smurn/knobly/knobly v1.jpg

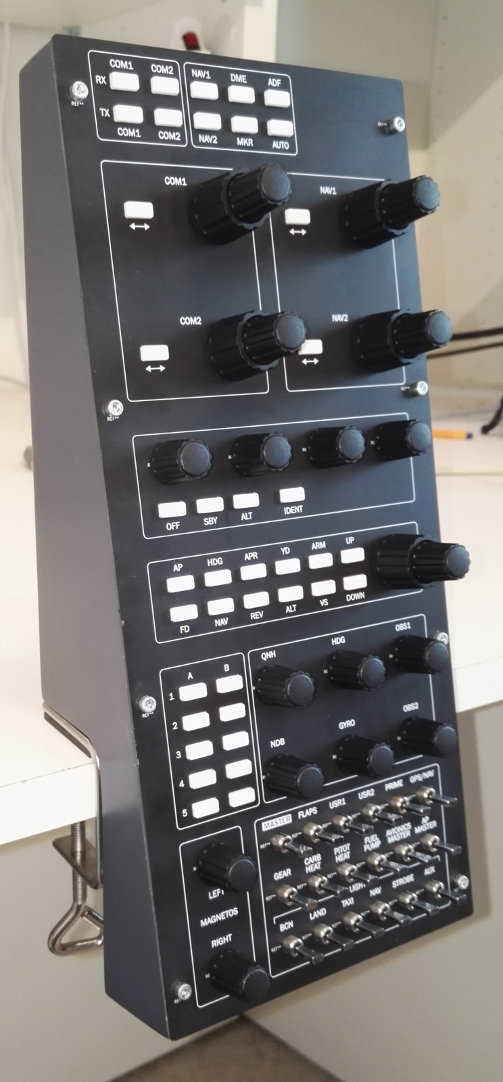
knobly v1.jpg
