smurn/knobly/populated pcb.jpg

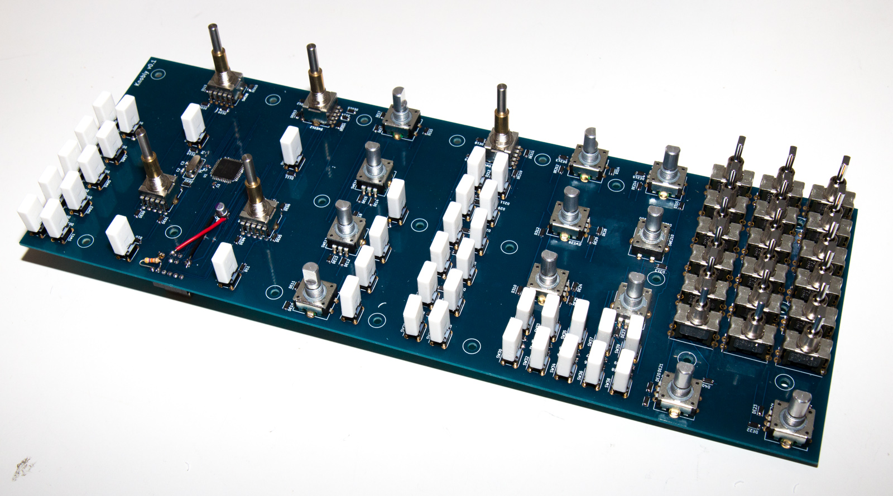
populated pcb.jpg
