smurn/knobly/README.txt

Knobly - Avionics input device for flight simulators
====================================================
