smurn/knobly/knoblyfirmware.X/README.txt

Warning:
If the programmer is connected, some buttons will show to be permanently pressed.
