smurn/knobly/3d-printed parts/topmount.stl

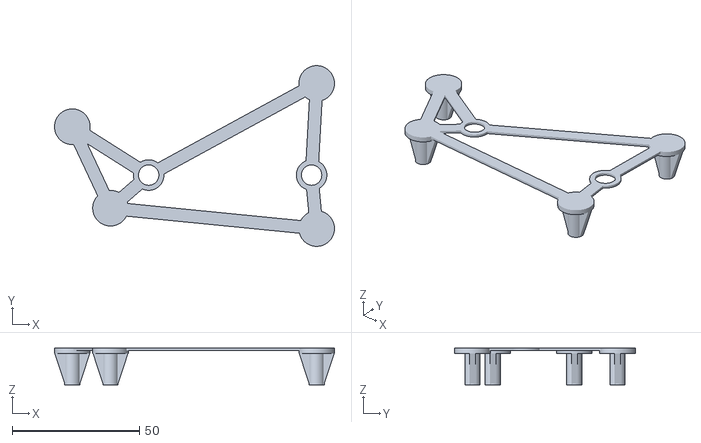
[picture p3: CAD file, 2017-12-11]
3d-printed parts/topmount.stl
110.0 x 71.0 x 14.4
