smurn/knobly/3d-printed parts/front_jig_5mm.stl

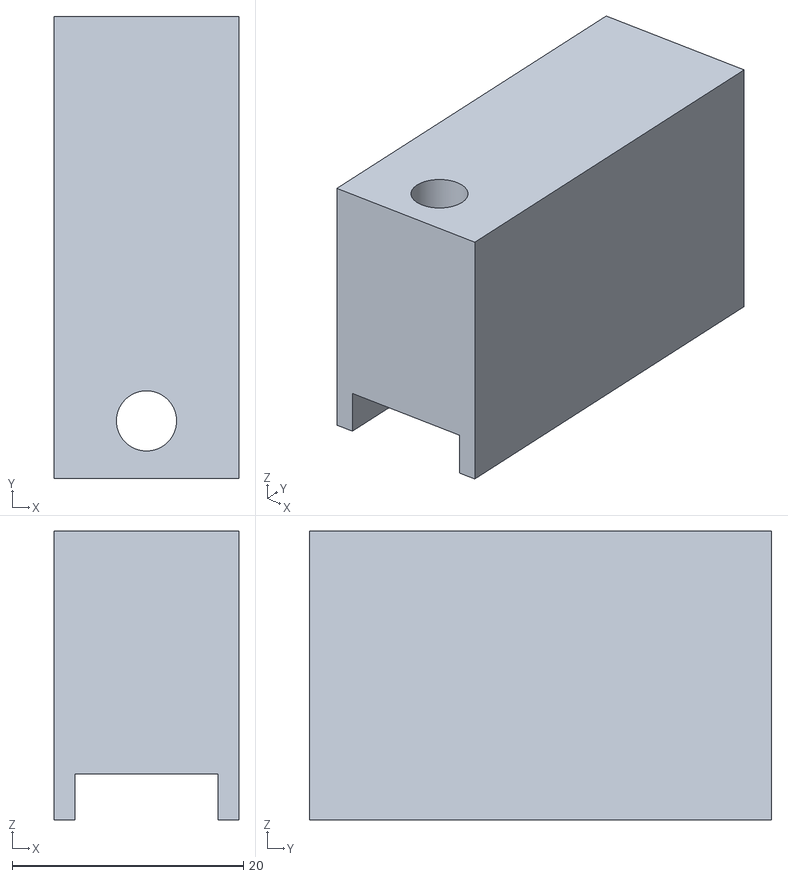
[picture p4: CAD file, 2017-12-11]
3d-printed parts/front_jig_5mm.stl
16.0 x 40.0 x 25.0
