smurn/knobly/3d-printed parts/distanceholder.stl

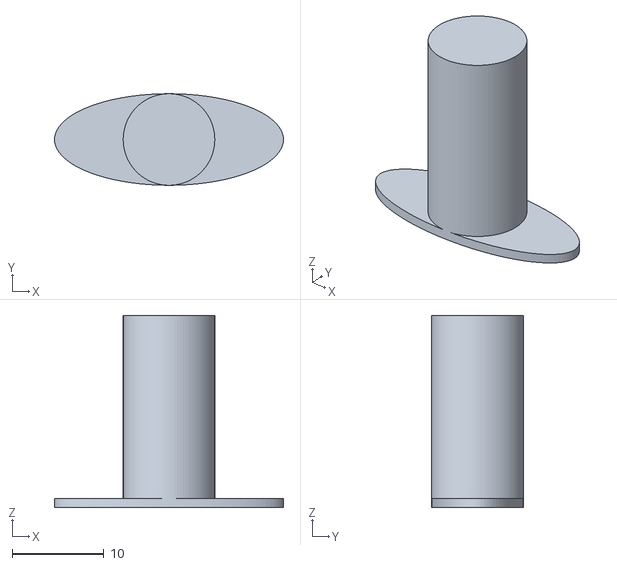
[picture p5: CAD file, 2017-12-11]
3d-printed parts/distanceholder.stl
25.0 x 9.99 x 21.0
