smurn/knobly/3d-printed parts/centermount.stl

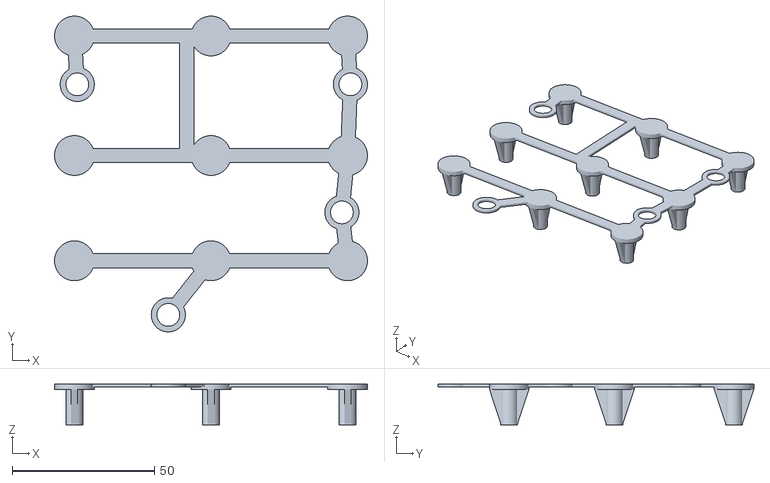
[picture p6: CAD file, 2017-12-11]
3d-printed parts/centermount.stl
110.0 x 111.0 x 14.4
