smurn/knobly/3d-printed parts/cap.stl

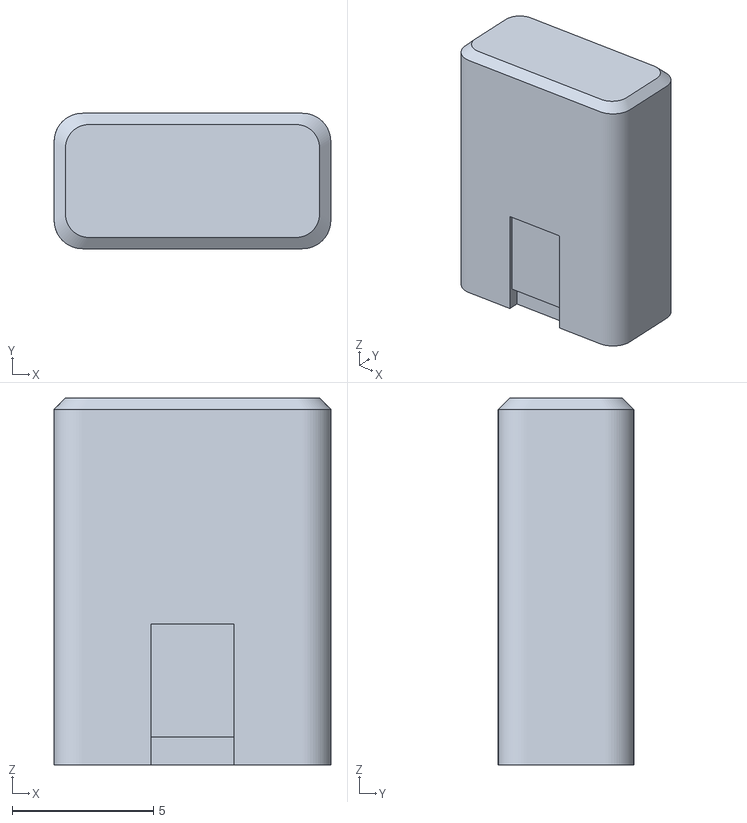
[picture p7: CAD file, 2017-12-11]
3d-printed parts/cap.stl
9.80 x 4.80 x 13.0
