smurn/knobly/3d-printed parts/clamp_side_jig.stl

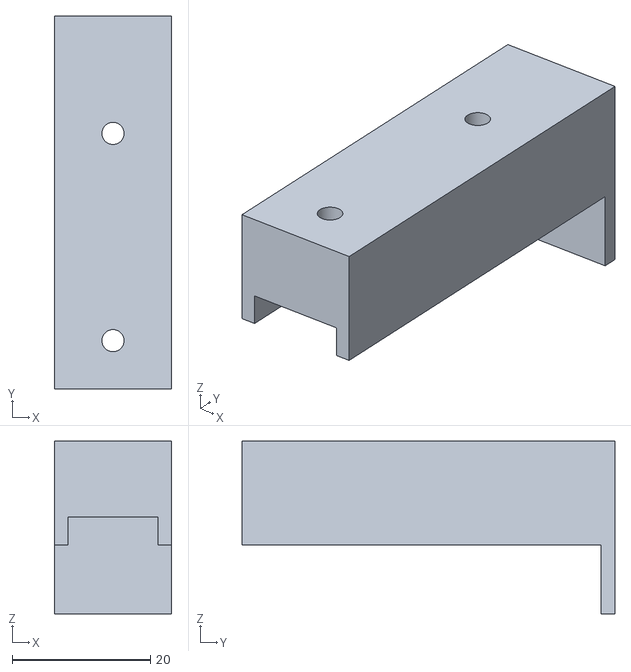
[picture p8: CAD file, 2017-12-11]
3d-printed parts/clamp_side_jig.stl
17.0 x 54.0 x 25.0
