smurn/knobly/3d-printed parts/clamp_top_jig.stl

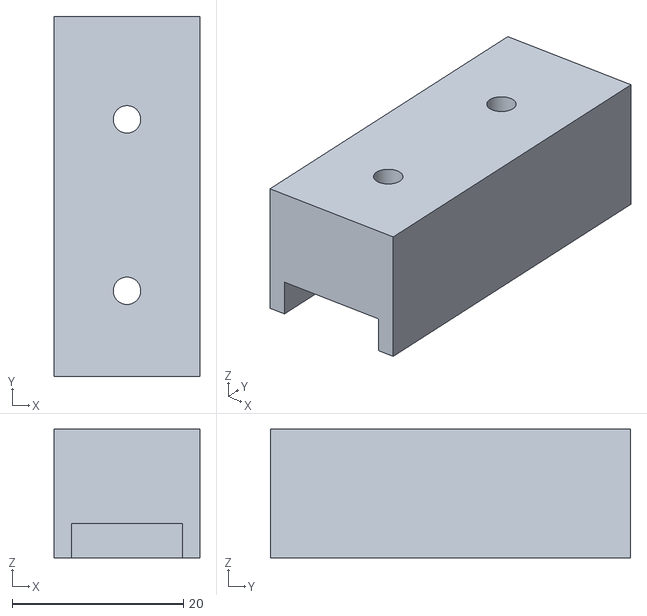
[picture p9: CAD file, 2017-12-11]
3d-printed parts/clamp_top_jig.stl
17.0 x 42.0 x 15.0
