smurn/knobly/3d-printed parts/clamp_plate.stl

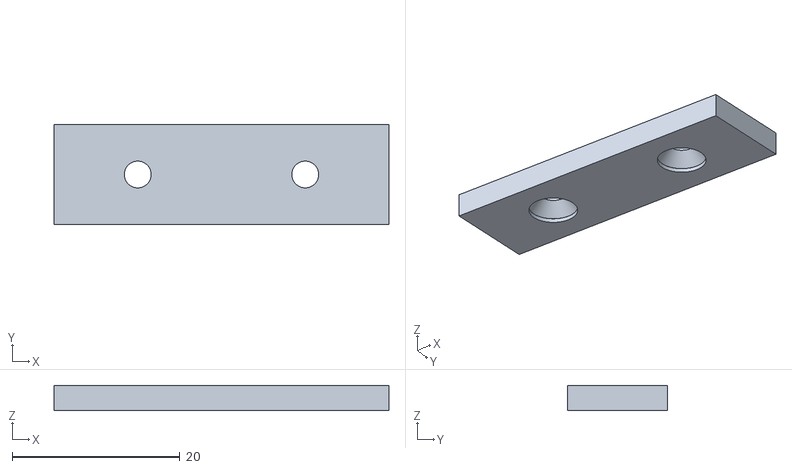
[picture p10: CAD file, 2017-12-11]
3d-printed parts/clamp_plate.stl
40.0 x 12.0 x 3.00
