smurn/knobly/3d-printed parts/frontmount.stl

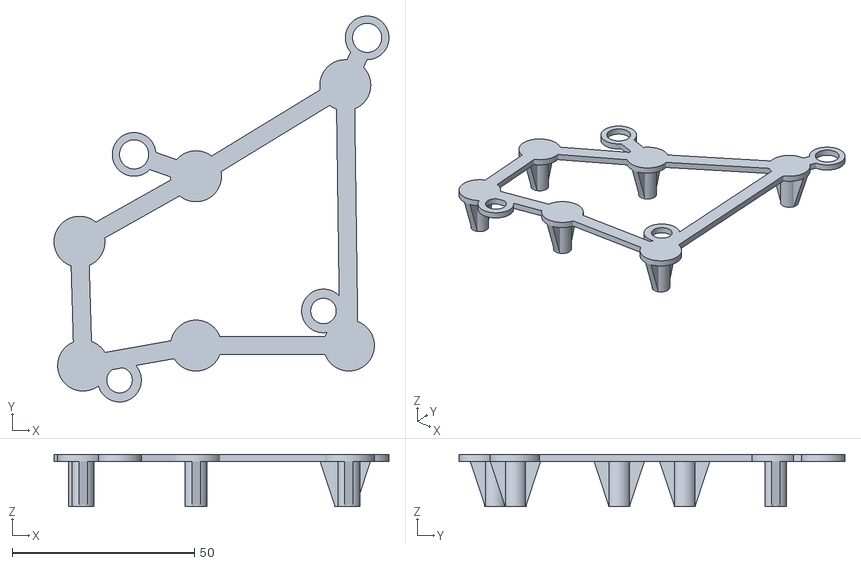
[picture p11: CAD file, 2017-12-11]
3d-printed parts/frontmount.stl
92.0 x 106.0 x 14.4
