smurn/knobly/3d-printed parts/e37_binary.stl

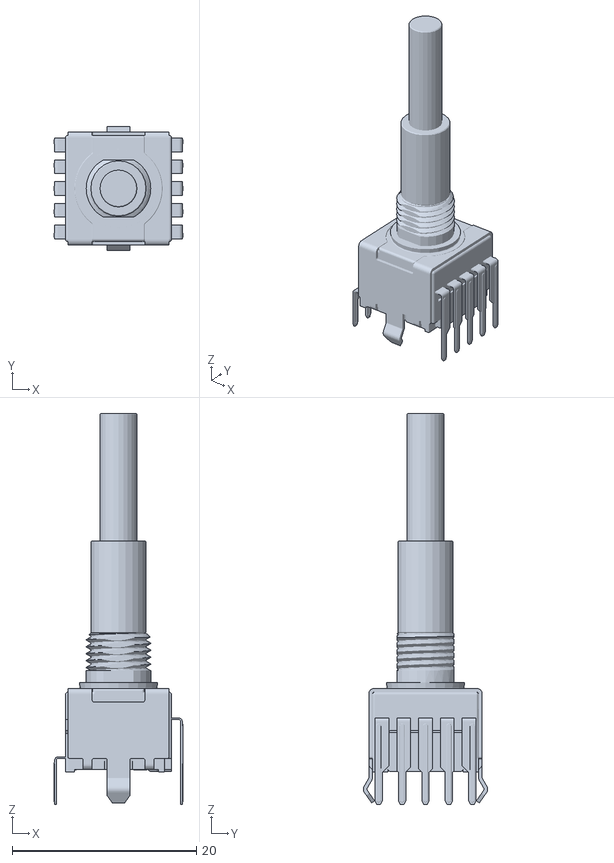
[picture p12: CAD file, 2017-12-11]
3d-printed parts/e37_binary.stl
14.0 x 13.5 x 42.4
