smurn/knobly/3d-printed parts/corner.stl

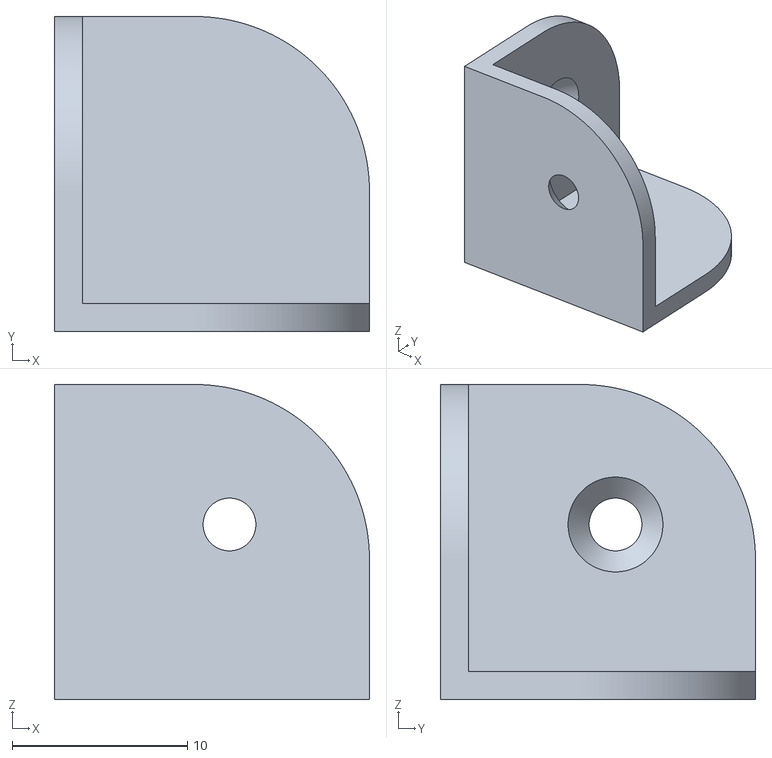
[picture p13: CAD file, 2017-12-11]
3d-printed parts/corner.stl
18.0 x 18.0 x 18.0
