smurn/knobly/3d-printed parts/front_jig.stl

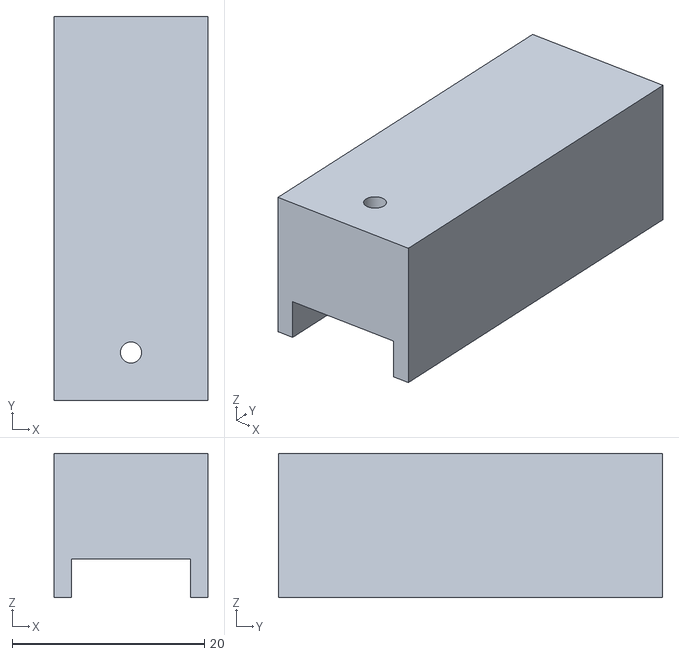
[picture p14: CAD file, 2017-12-11]
3d-printed parts/front_jig.stl
16.0 x 40.0 x 15.0
