smurn/knobly/3d-printed parts/M2018ES2G13_binary.stl

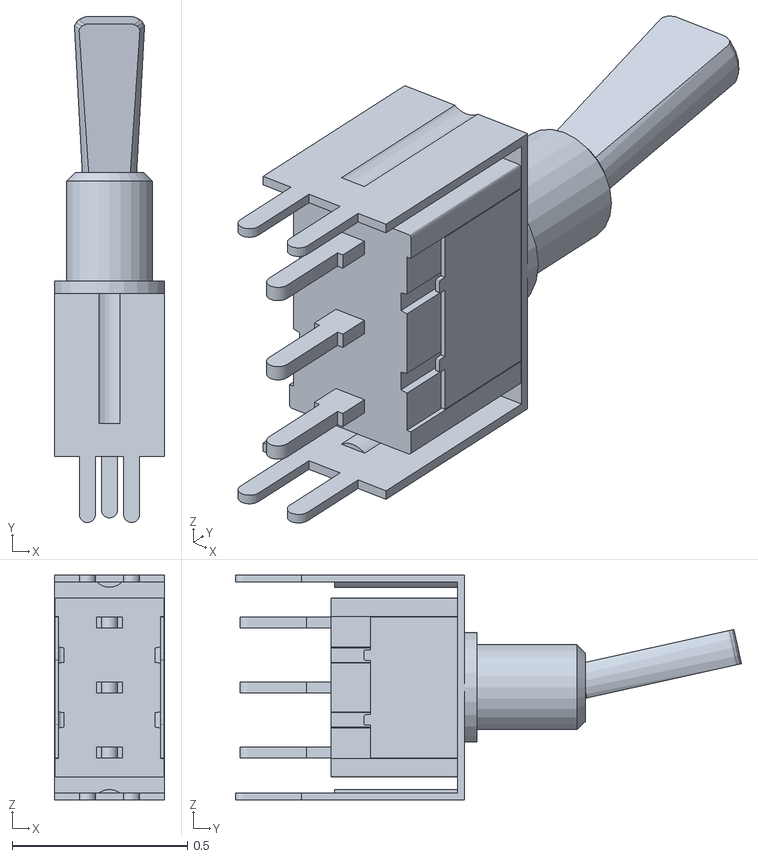
[picture p15: CAD file, 2017-12-11]
3d-printed parts/M2018ES2G13_binary.stl
0.315 x 1.44 x 0.642
