smurn/knobly/3d-printed parts/distanceholder.scad

$fa = 4;
$fs = 0.2;

cylinder(r=5,h=21);
scale([2.5,1,1])cylinder(r=5,h=1);
