smurn/knobly/(list of files, cad)

Other CAD files:
3d-printed parts/e37_binary2.stl
3d-printed parts/e37.stl
older stuff/knobly2.X/dist/default/production/knobly2.X.production.obj
older stuff/12039.stp
older stuff/CH13-E37-Dummy-E37-VTXXX0-1-C.stp
older stuff/M2018ES2G13.stp
older stuff/bottommount.stl
older stuff/case.FCStd
older stuff/e37.obj
older stuff/e37.stl
older stuff/e37_binary2.stl
older stuff/pec11r-4x25f-sxxxx.stp
