smurn/knobly/pcb/encmatrix-encoder matrix.pdf

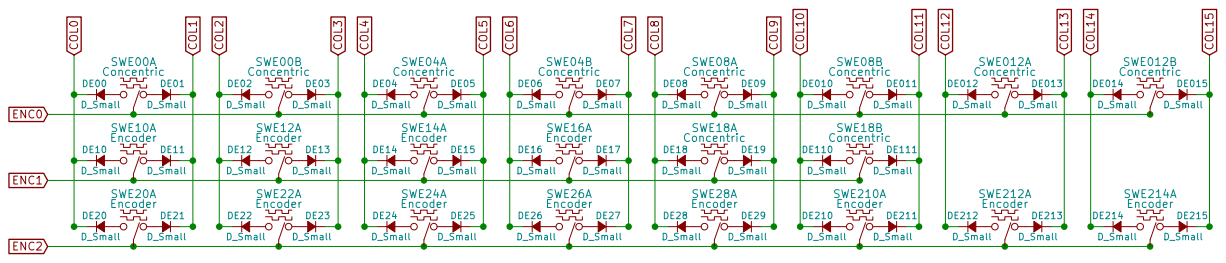
[picture p17: page 1]

File: encmatrix.sch Sheet: /encoder matrix/
Id: 4/4 Title: Rotary Encoder Matrix
