smurn/knobly/pcb/matrix-matrix.pdf

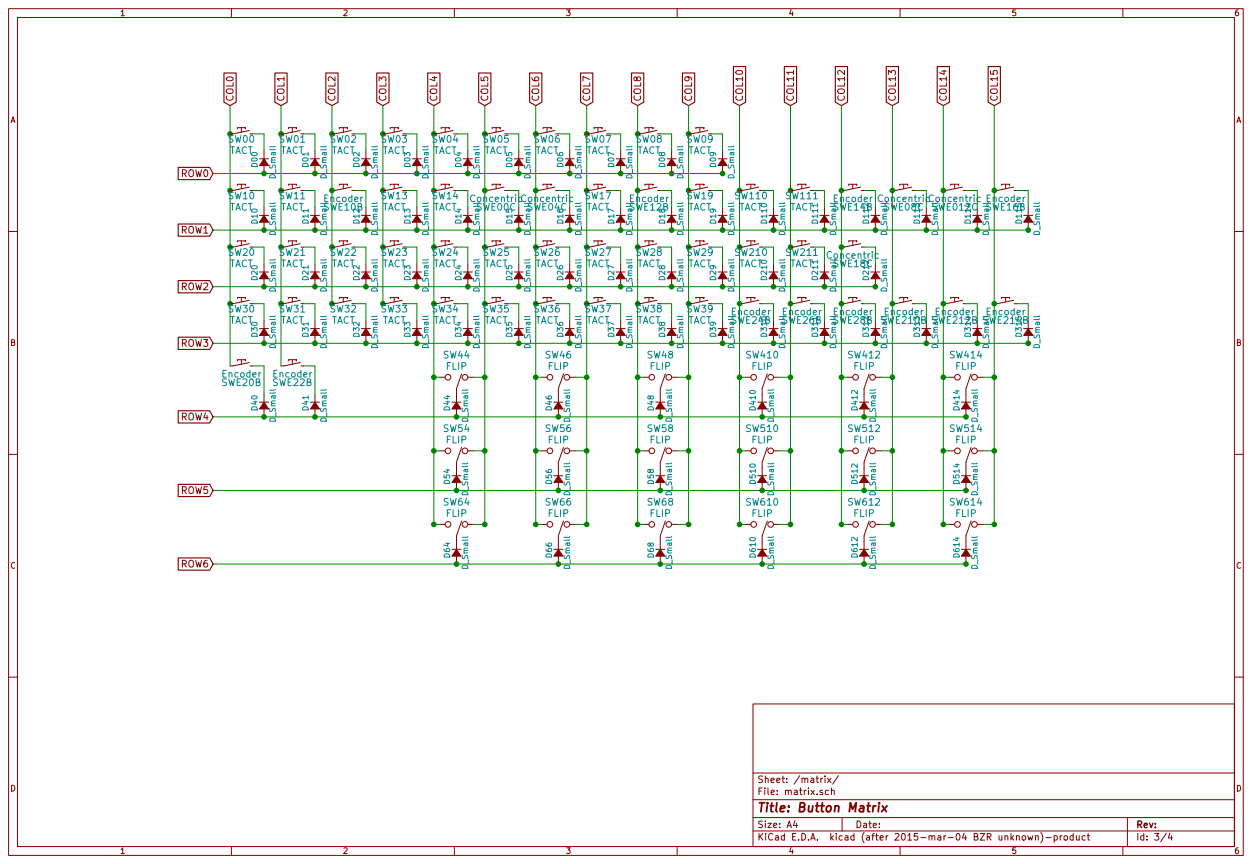
[picture p18: page 1]

Id: 3/4 Title: Button Matrix
