smurn/knobly/pcb/controller-controller.pdf

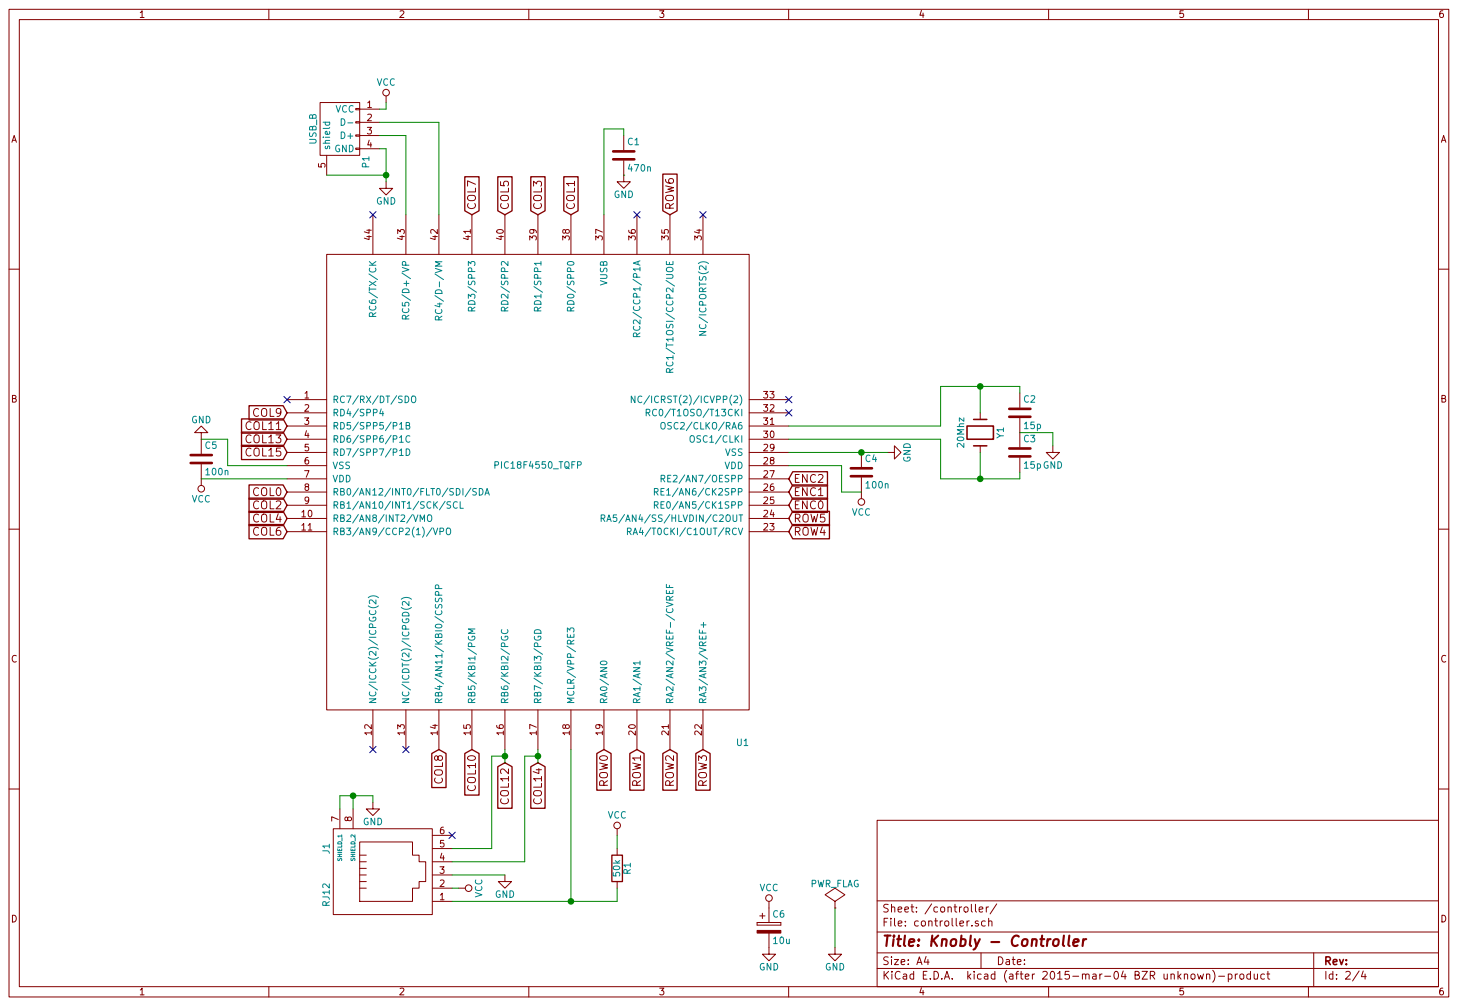
[picture p19: page 1]

Id: 2/4 Title: Knobly - Controller File: controller.sch Sheet: /controller/
