smurn/knobly/pcb/frontpanel.pdf

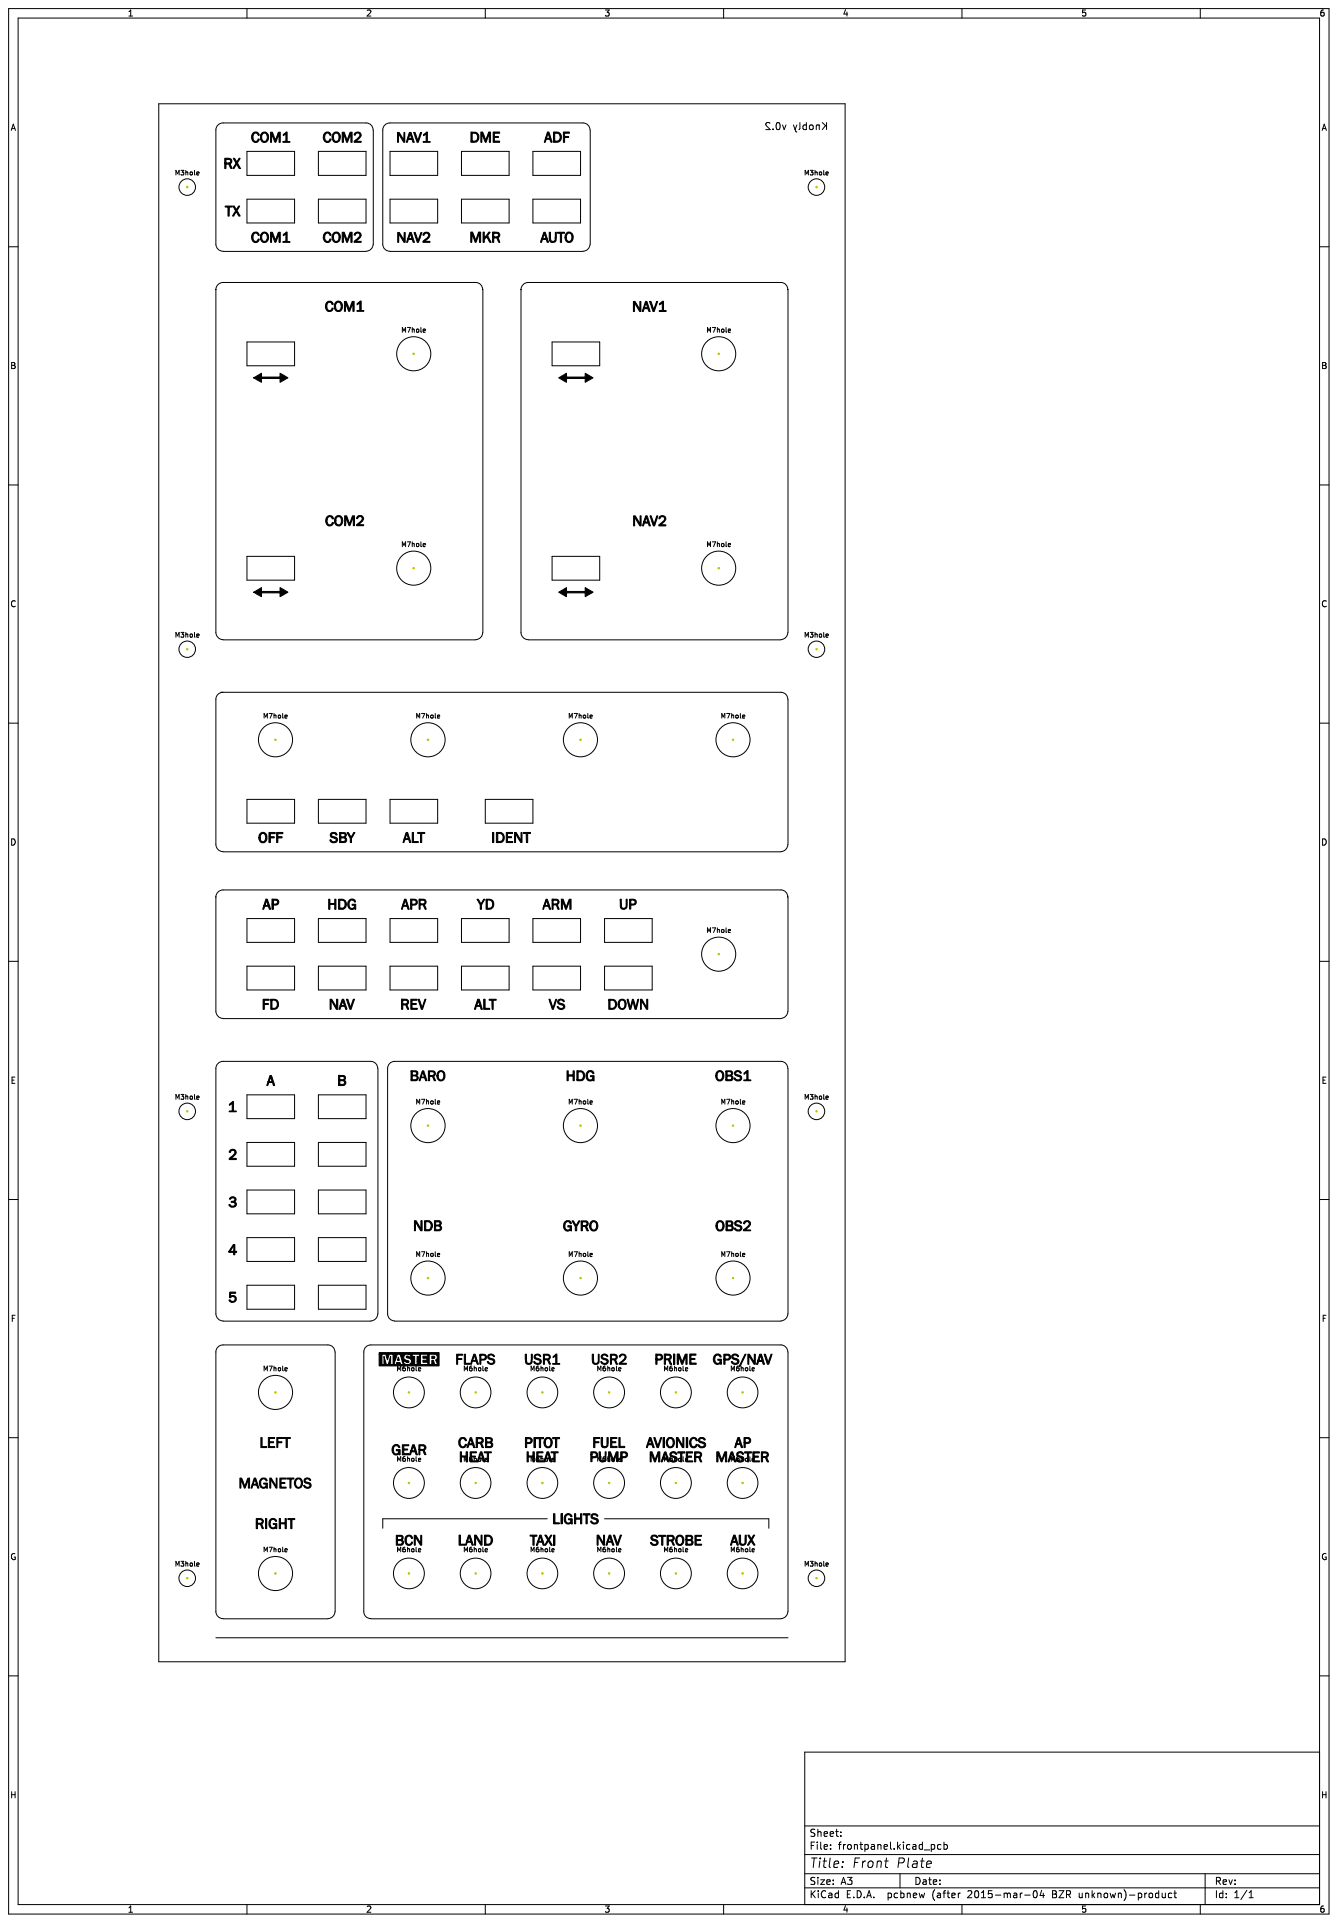
[picture p20: page 1]
