smurn/knobly/pcb/secondtry-B.Cu.pdf

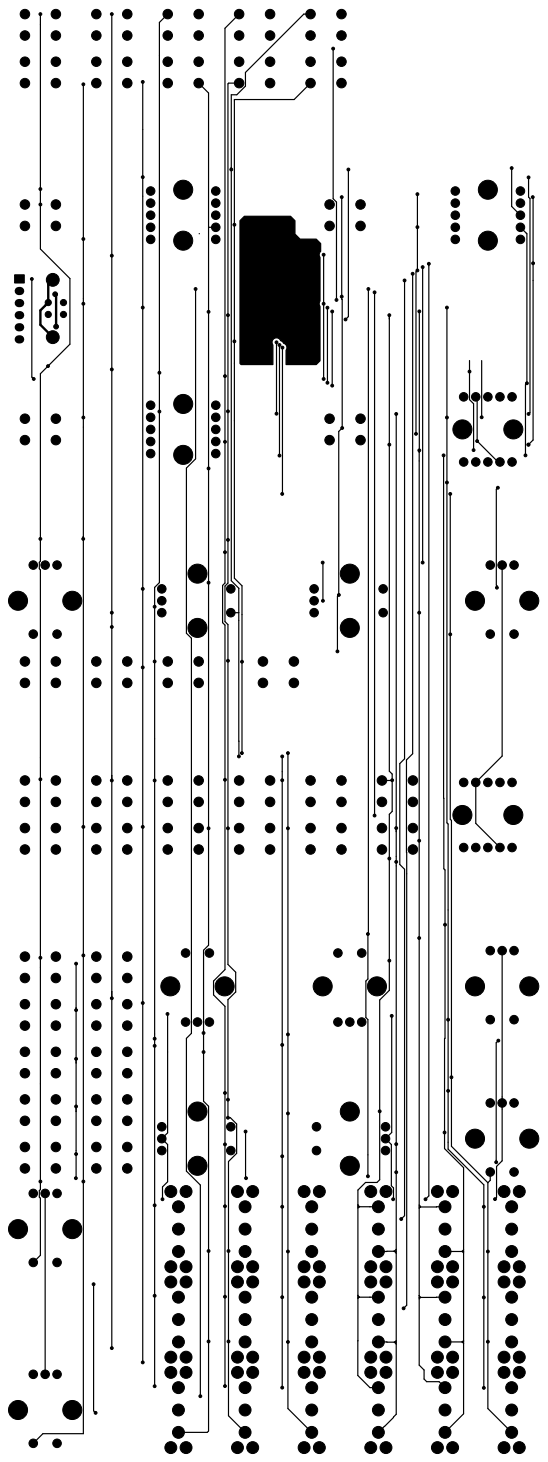
[picture p21: page 1]
