smurn/knobly/pcb/secondtry-B.SilkS.pdf

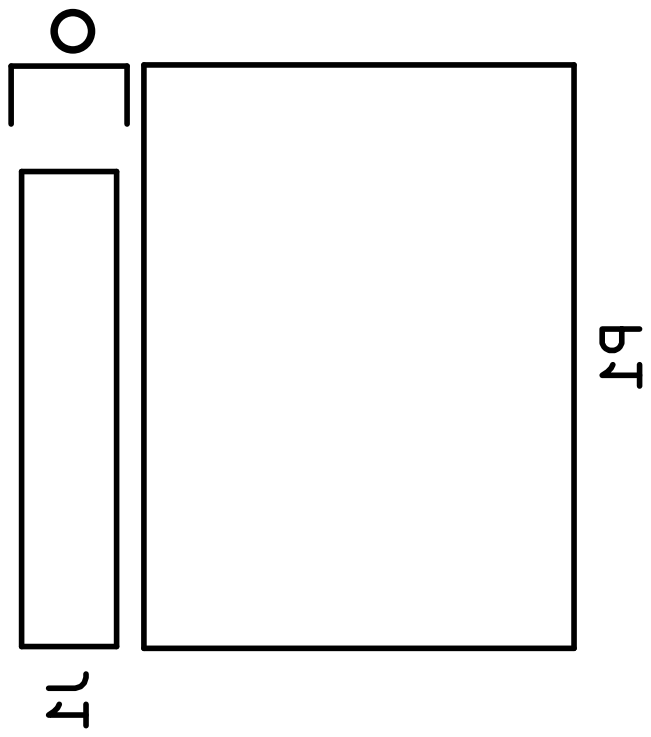
[picture p22: page 1]
