smurn/knobly/pcb/secondtry-F.Cu.pdf

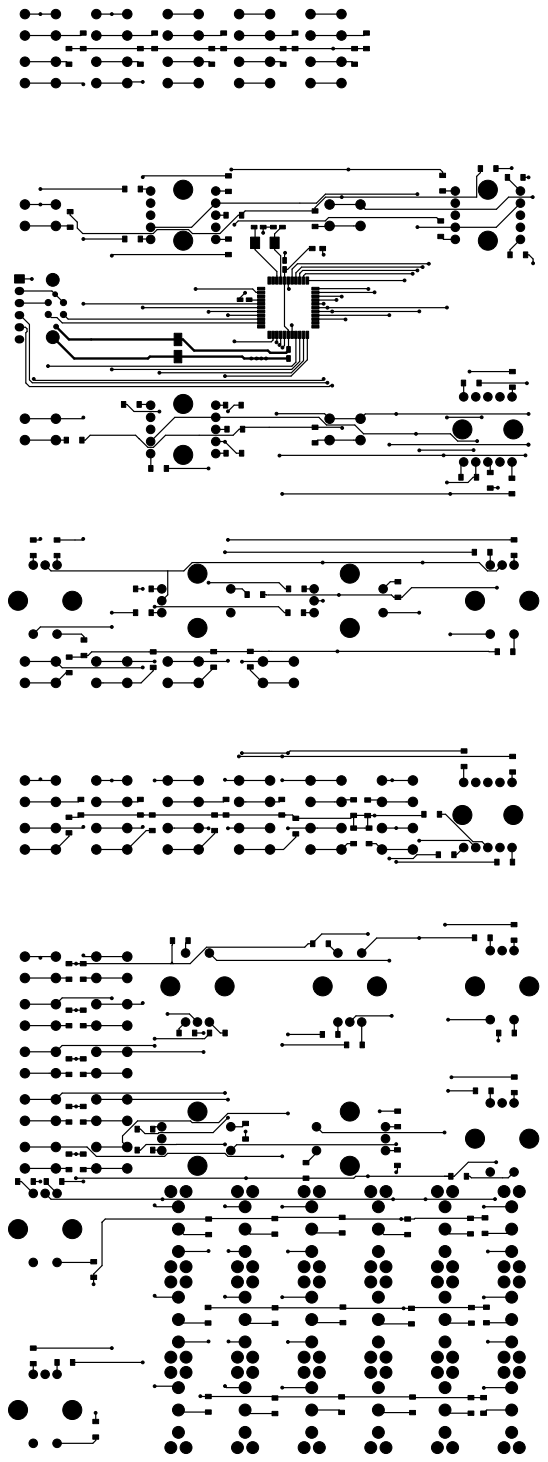
[picture p23: page 1]
