smurn/knobly/pcb/secondtry-F.SilkS.pdf

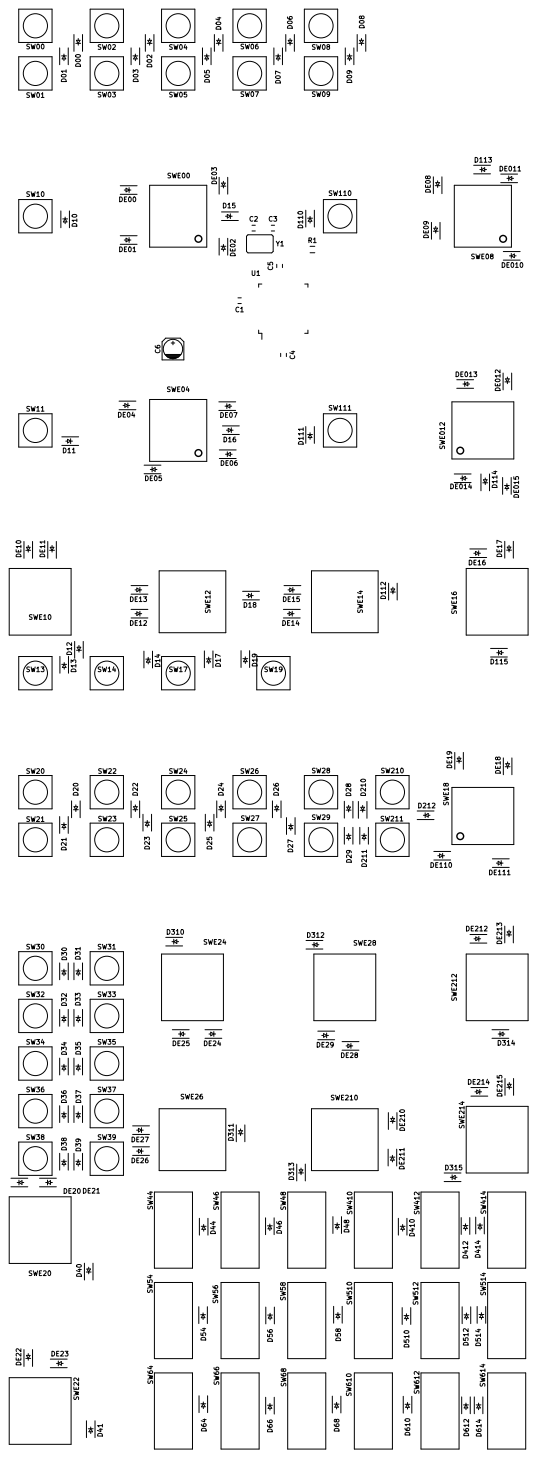
[picture p24: page 1]
