smurn/knobly/pcb/gerber_front/frontpanel-Edge_Cuts.pdf

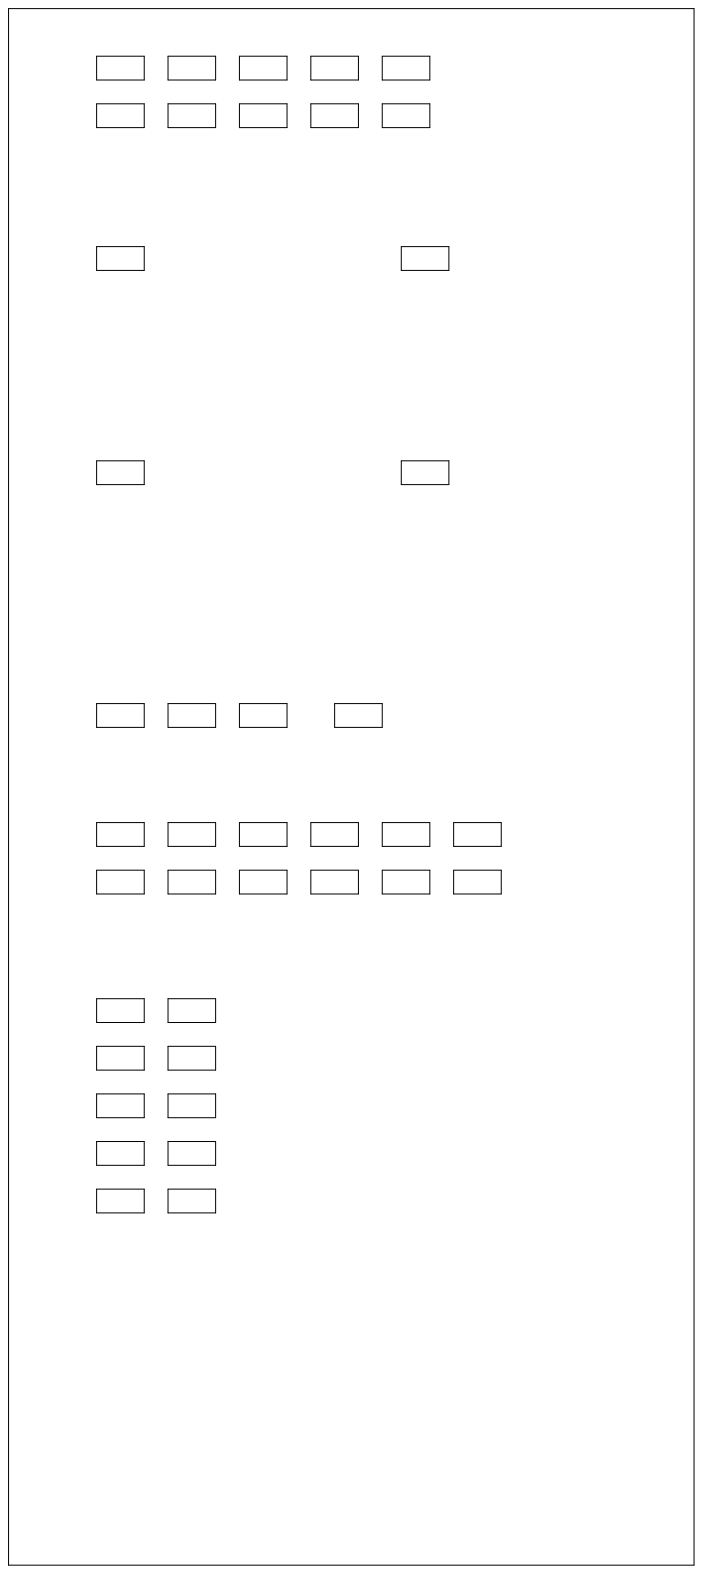
[picture p25: page 1]
