smurn/knobly/pcb/gerber_front/frontpanel-F_SilkS.pdf

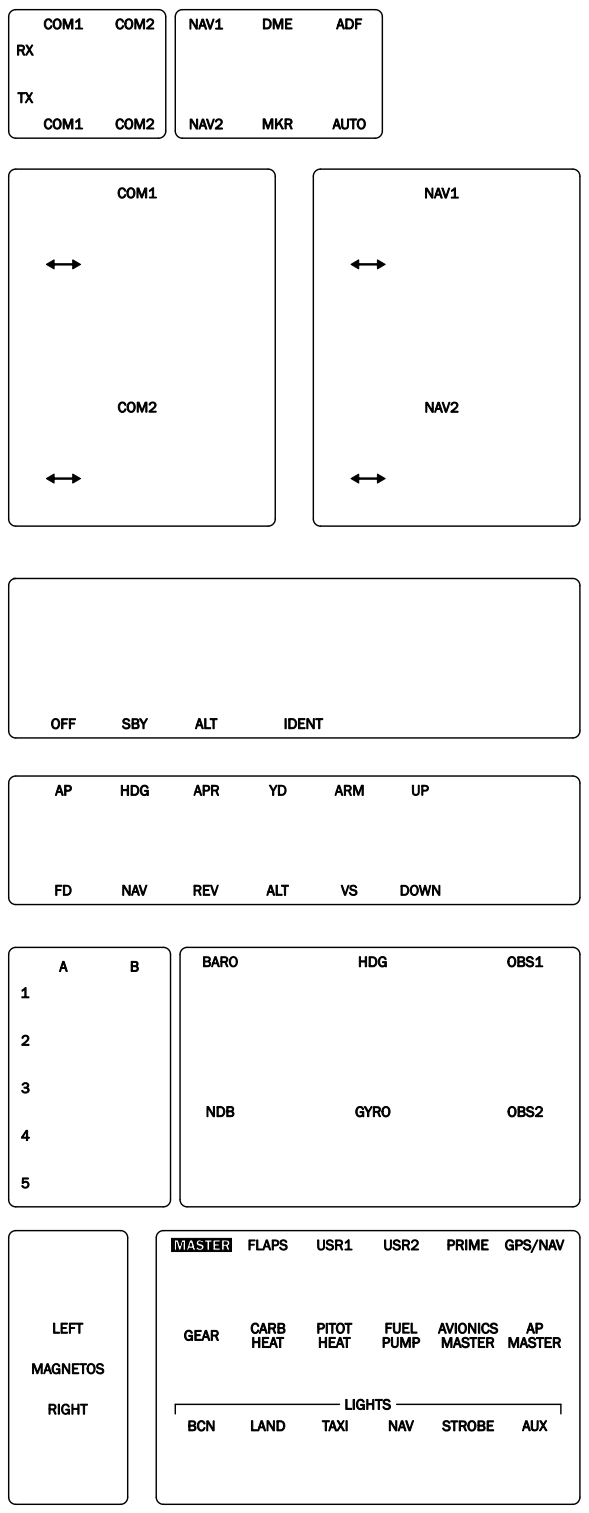
[picture p26: page 1]
