smurn/knobly/older stuff/components.pdf

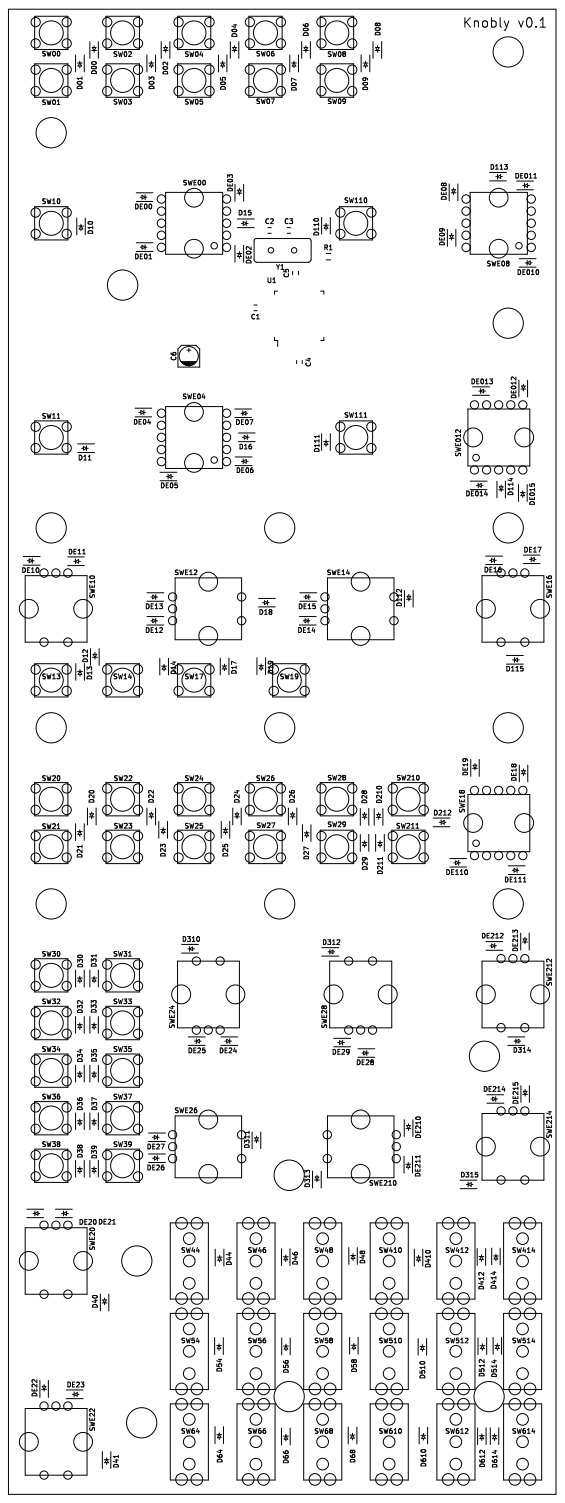
[picture p27: page 1]
