smurn/knobly/older stuff/Printing Print.pdf

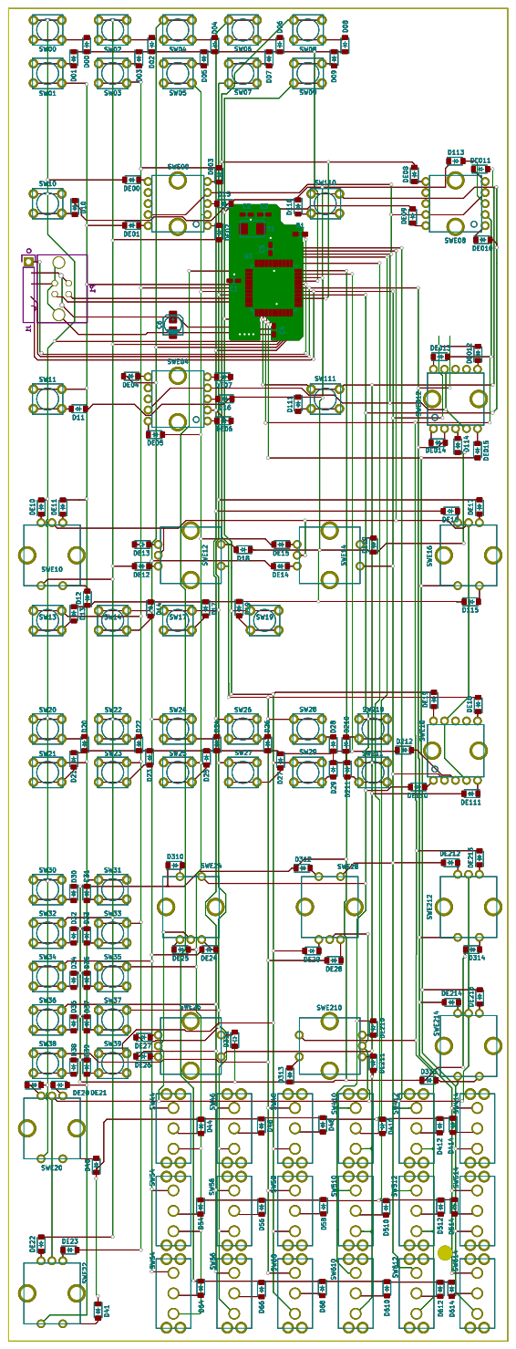
[picture p28: page 1]
