smurn/knobly/older stuff/componentsback.pdf

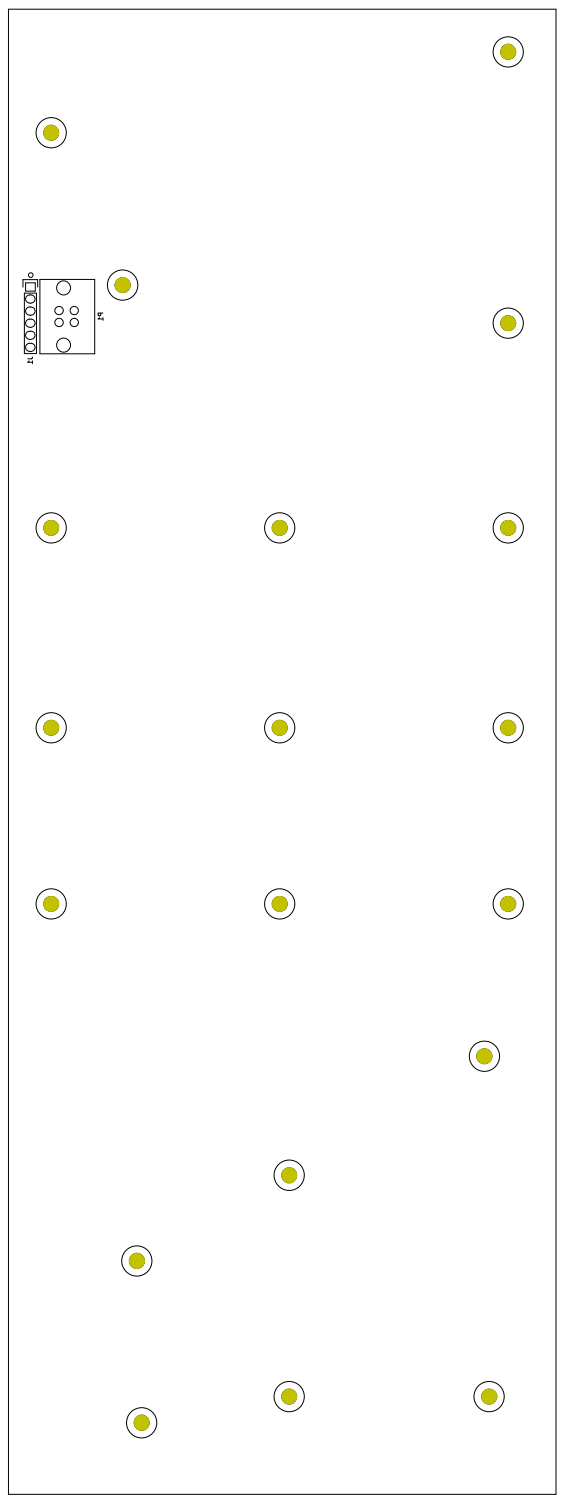
[picture p29: page 1]
