smurn/knobly/older stuff/frontpanel.pdf

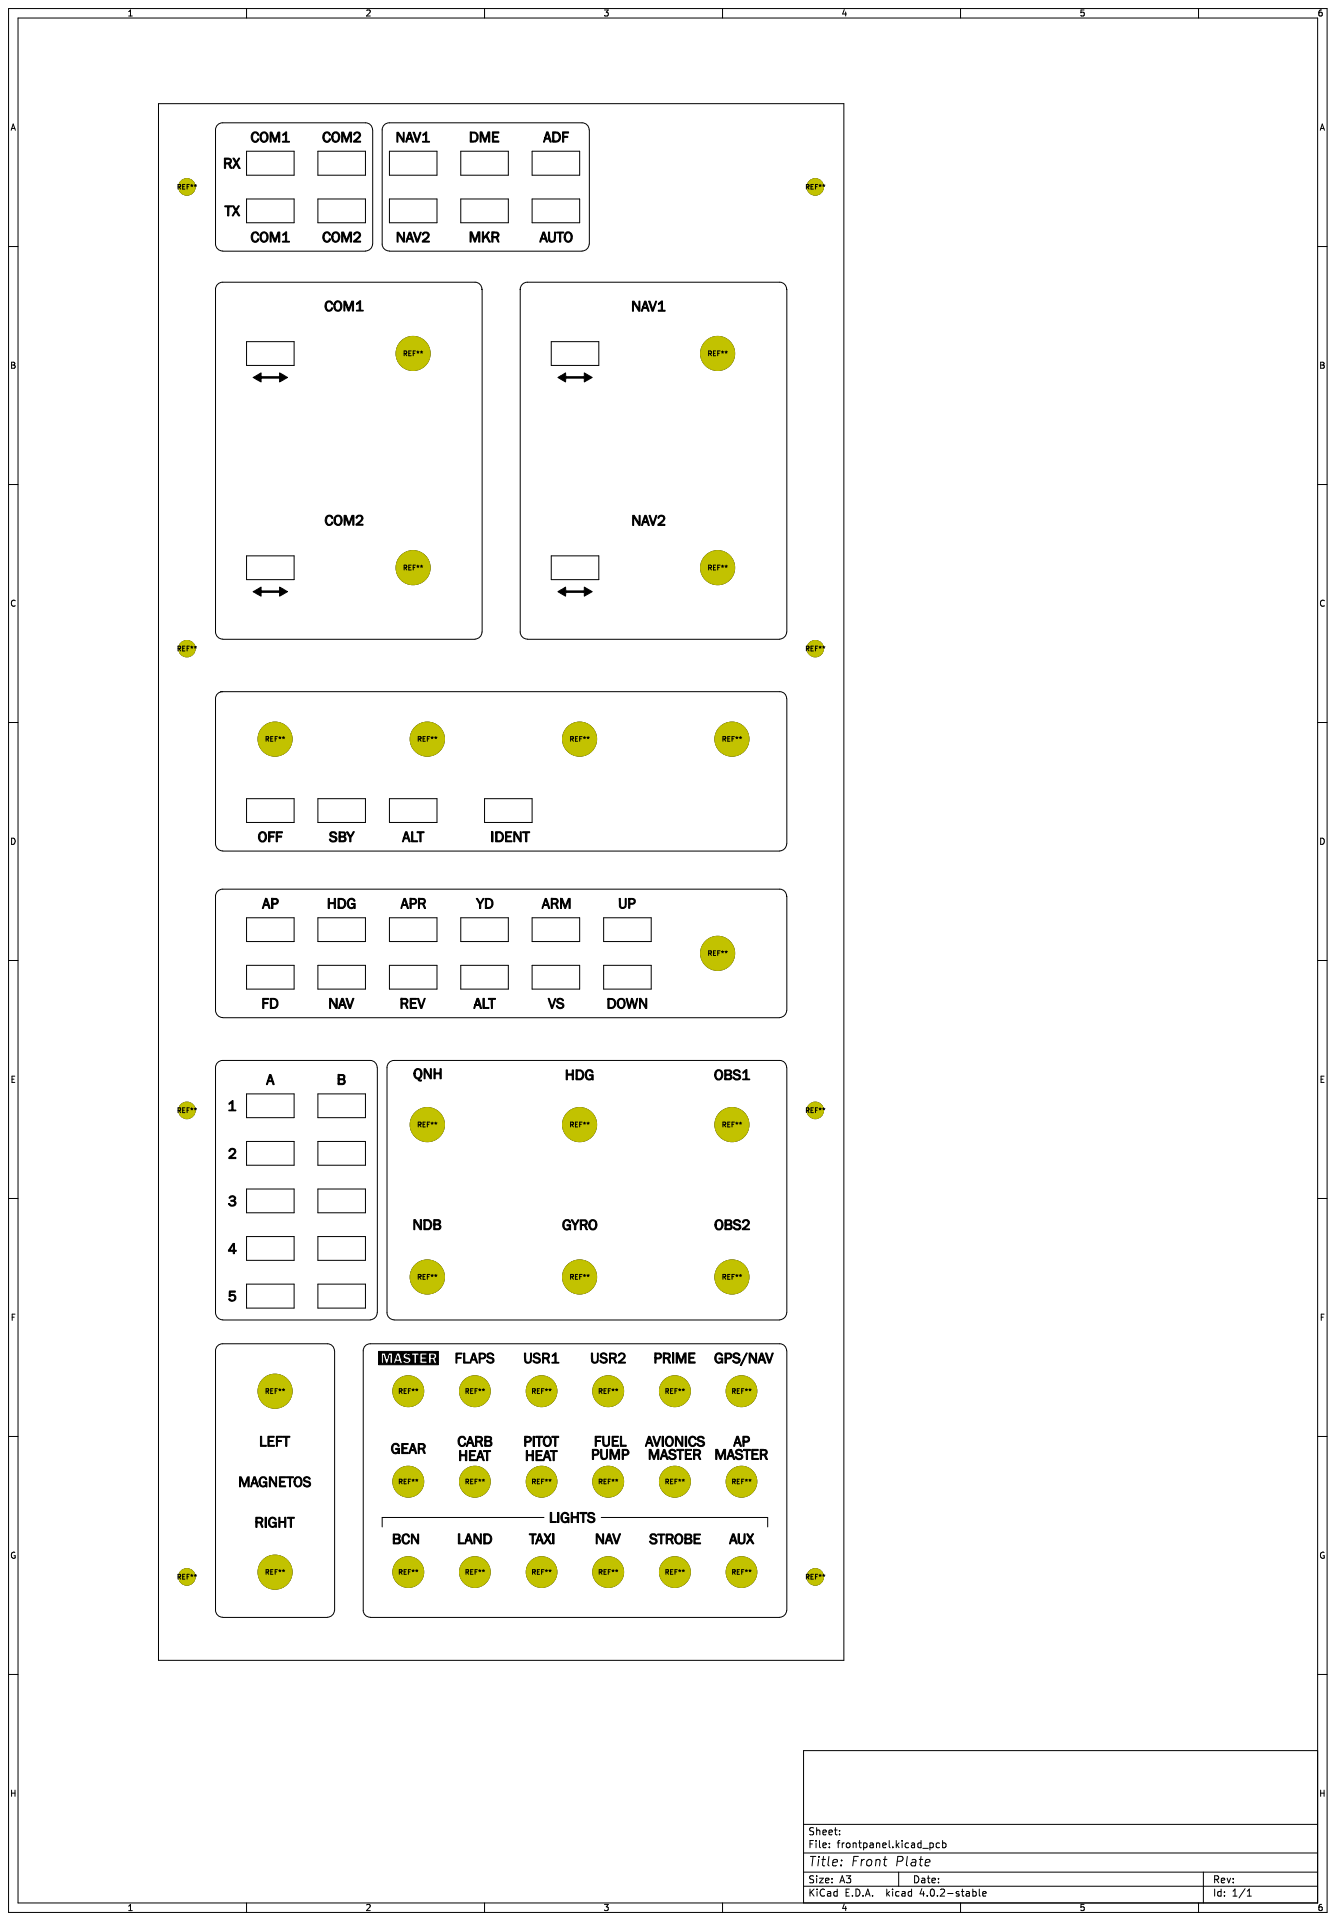
[picture p30: page 1]
