smurn/knobly/older stuff/pcb/knobly.kicad_pcb

## KiCad design older stuff/pcb/knobly.kicad_pcb (2017-12-11, an earlier design)

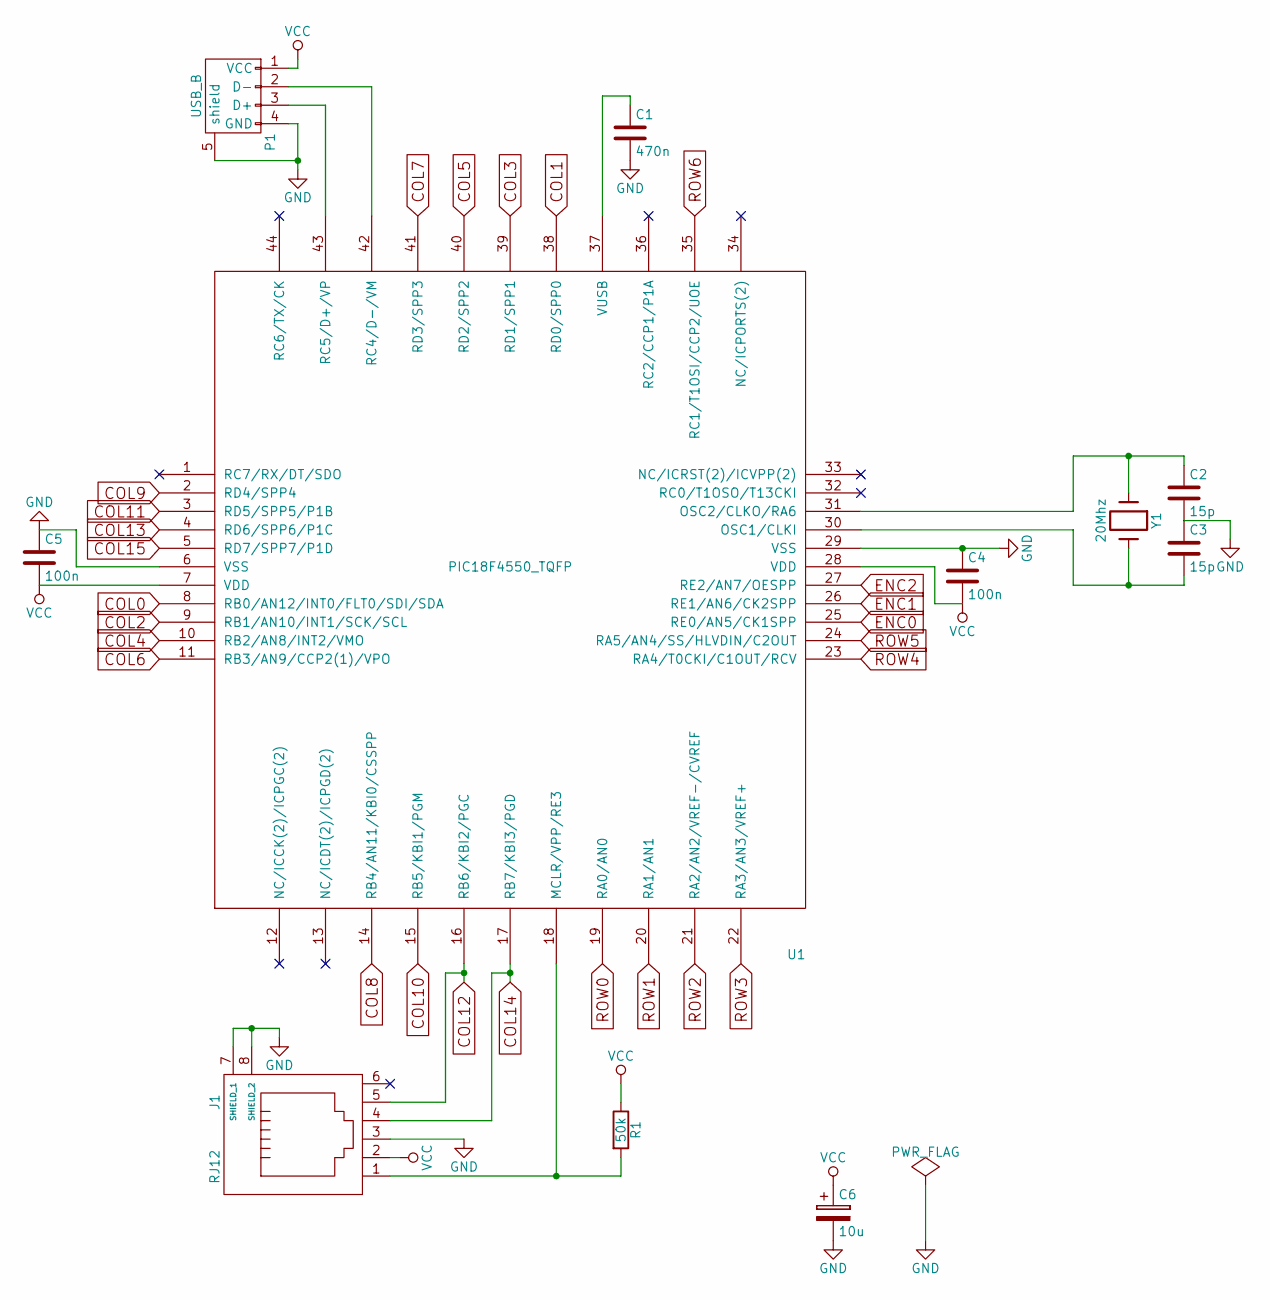
[picture p31: schematic controller.sch, Knobly - Controller]

Parts:
C1: 470n; C_0603_HandSoldering
C2, C3: 15p; C_0603_HandSoldering
C4, C5: 100n; C_0603_HandSoldering
C6: 10u; c_elec_4x4.5
J1: RJ12; Socket_Strip_Straight_1x06
P1: USB_B; USBBVertical
R1: 50k; R_0603_HandSoldering
U1: PIC18F4550_TQFP; TQFP-44_10x10mm_Pitch0.8mm
Y1: 20Mhz; HC49US

Connections:
COL0: U1.8 (RB0/AN12/INT0/FLT0/SDI/SDA); also elsewhere on the board
COL1: U1.38 (RD0/SPP0); also elsewhere on the board
COL2: U1.9 (RB1/AN10/INT1/SCK/SCL); also elsewhere on the board
COL3: U1.39 (RD1/SPP1); also elsewhere on the board
COL4: U1.10 (RB2/AN8/INT2/VMO); also elsewhere on the board
COL5: U1.40 (RD2/SPP2); also elsewhere on the board
COL6: U1.11 (RB3/AN9/CCP2(1)/VPO); also elsewhere on the board
COL7: U1.41 (RD3/SPP3); also elsewhere on the board
COL8: U1.14 (RB4/AN11/KBI0/CSSPP); also elsewhere on the board
COL9: U1.2 (RD4/SPP4); also elsewhere on the board
COL10: U1.15 (RB5/KBI1/PGM); also elsewhere on the board
COL11: U1.3 (RD5/SPP5/P1B); also elsewhere on the board
COL12: J1.5, U1.16 (RB6/KBI2/PGC); also elsewhere on the board
COL13: U1.4 (RD6/SPP6/P1C); also elsewhere on the board
COL14: J1.4, U1.17 (RB7/KBI3/PGD); also elsewhere on the board
COL15: U1.5 (RD7/SPP7/P1D); also elsewhere on the board
ENC0: U1.25 (RE0/AN5/CK1SPP); also elsewhere on the board
ENC1: U1.26 (RE1/AN6/CK2SPP); also elsewhere on the board
ENC2: U1.27 (RE2/AN7/OESPP); also elsewhere on the board
unnamed: C1.1, U1.37 (VUSB)
unnamed: C2.1, U1.31 (OSC2/CLKO/RA6), Y1.1
unnamed: C3.2, U1.30 (OSC1/CLKI), Y1.2
unnamed: J1.1, R1.2, U1.18 (MCLR/VPP/RE3)
unnamed: P1.2 (D-), U1.42 (RC4/D-/VM)
unnamed: P1.3 (D+), U1.43 (RC5/D+/VP)
ROW0: U1.19 (RA0/AN0); also elsewhere on the board
ROW1: U1.20 (RA1/AN1); also elsewhere on the board
ROW2: U1.21 (RA2/AN2/VREF-/CVREF); also elsewhere on the board
ROW3: U1.22 (RA3/AN3/VREF+); also elsewhere on the board
ROW4: U1.23 (RA4/T0CKI/C1OUT/RCV); also elsewhere on the board
ROW5: U1.24 (RA5/AN4/SS/HLVDIN/C2OUT); also elsewhere on the board
ROW6: U1.35 (RC1/T1OSI/CCP2/UOE); also elsewhere on the board

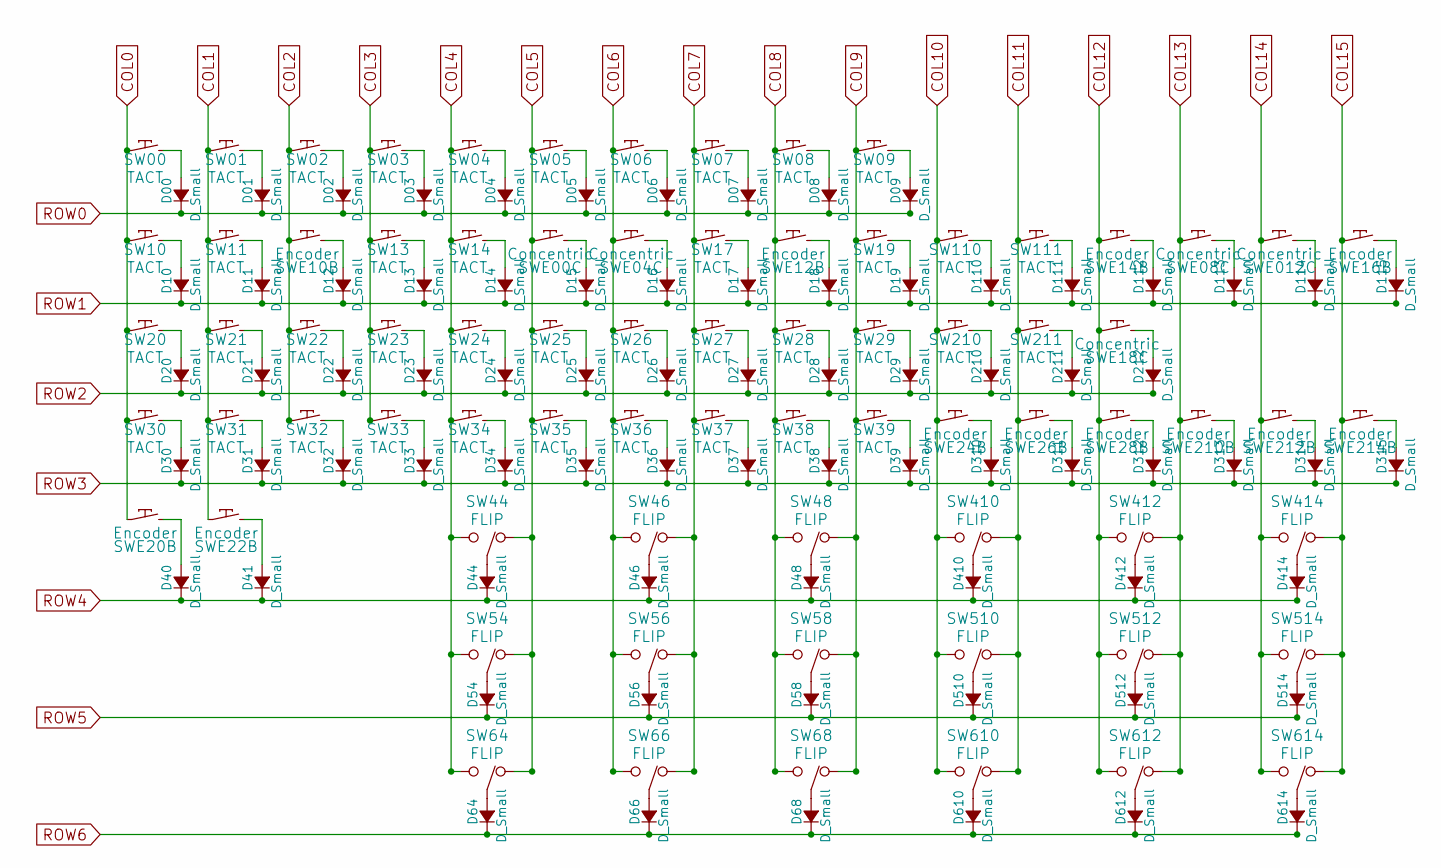
[picture p32: schematic matrix.sch, Button Matrix]

Parts:
D00, D01, D02, D03, D04, D05, D06, D07, D08, D09, D10, D11, D12, D13, D14, D15, D16, D17, D18, D19, D20, D21, D22, D23, D24, D25, D26, D27, D28, D29, D30, D31, D32, D33, D34, D35, D36, D37, D38, D39, D40, D41, D44, D46, D48, D54, D56, D58, D64, D66, D68, D110, D111, D112, D113, D114, D115, D210, D211, D212, D310, D311, D312, D313, D314, D315, D410, D412, D414, D510, D512, D514, D610, D612, D614: D_Small; SOD-123
SW00, SW01, SW02, SW03, SW04, SW05, SW06, SW07, SW08, SW09, SW10, SW11, SW13, SW14, SW17, SW19, SW20, SW21, SW22, SW23, SW24, SW25, SW26, SW27, SW28, SW29, SW30, SW31, SW32, SW33, SW34, SW35, SW36, SW37, SW38, SW39, SW110, SW111, SW210, SW211: TACT
SW44, SW46, SW48, SW54, SW56, SW58, SW64, SW66, SW68, SW410, SW412, SW414, SW510, SW512, SW514, SW610, SW612, SW614: FLIP; M2018ES2G13
SWE00, SWE04, SWE08, SWE012, SWE18: Concentric; e37
SWE10, SWE12, SWE14, SWE16, SWE20, SWE22, SWE24, SWE26, SWE28, SWE210, SWE212, SWE214: Encoder; pec11r

Connections:
COL0: SW00.1, SW10.1, SW20.1, SW30.1, SWE20.5; also elsewhere on the board
COL1: SW01.1, SW11.1, SW21.1, SW31.1, SWE22.5; also elsewhere on the board
COL2: SW02.1, SW22.1, SW32.1, SWE10.5; also elsewhere on the board
COL3: SW03.1, SW13.1, SW23.1, SW33.1; also elsewhere on the board
COL4: SW04.1, SW14.1, SW24.1, SW34.1, SW44.3, SW54.3, SW64.3; also elsewhere on the board
COL5: SW05.1, SW25.1, SW35.1, SW44.1, SW54.1, SW64.1, SWE00.2 (S1); also elsewhere on the board
COL6: SW06.1, SW26.1, SW36.1, SW46.3, SW56.3, SW66.3, SWE04.2 (S1); also elsewhere on the board
COL7: SW07.1, SW17.1, SW27.1, SW37.1, SW46.1, SW56.1, SW66.1; also elsewhere on the board
COL8: SW08.1, SW28.1, SW38.1, SW48.3, SW58.3, SW68.3, SWE12.5; also elsewhere on the board
COL9: SW09.1, SW19.1, SW29.1, SW39.1, SW48.1, SW58.1, SW68.1; also elsewhere on the board
COL10: SW110.1, SW210.1, SW410.3, SW510.3, SW610.3, SWE24.5; also elsewhere on the board
COL11: SW111.1, SW211.1, SW410.1, SW510.1, SW610.1, SWE26.5; also elsewhere on the board
COL12: SW412.3, SW512.3, SW612.3, SWE14.5, SWE18.2 (S1), SWE28.5; also elsewhere on the board
COL13: SW412.1, SW512.1, SW612.1, SWE08.2 (S1), SWE210.5; also elsewhere on the board
COL14: SW414.3, SW514.3, SW614.3, SWE012.2 (S1), SWE212.5; also elsewhere on the board
COL15: SW414.1, SW514.1, SW614.1, SWE16.5, SWE214.5; also elsewhere on the board
unnamed: D00.2 (A), SW00.2
unnamed: D01.2 (A), SW01.2
unnamed: D02.2 (A), SW02.2
unnamed: D03.2 (A), SW03.2
unnamed: D04.2 (A), SW04.2
unnamed: D05.2 (A), SW05.2
unnamed: D06.2 (A), SW06.2
unnamed: D07.2 (A), SW07.2
unnamed: D08.2 (A), SW08.2
unnamed: D09.2 (A), SW09.2
unnamed: D10.2 (A), SW10.2
unnamed: D11.2 (A), SW11.2
unnamed: D12.2 (A), SWE10.4
unnamed: D13.2 (A), SW13.2
unnamed: D14.2 (A), SW14.2
unnamed: D15.2 (A), SWE00.3 (S2)
unnamed: D16.2 (A), SWE04.3 (S2)
unnamed: D17.2 (A), SW17.2
unnamed: D18.2 (A), SWE12.4
unnamed: D19.2 (A), SW19.2
unnamed: D20.2 (A), SW20.2
unnamed: D21.2 (A), SW21.2
unnamed: D22.2 (A), SW22.2
unnamed: D23.2 (A), SW23.2
unnamed: D24.2 (A), SW24.2
unnamed: D25.2 (A), SW25.2
unnamed: D26.2 (A), SW26.2
unnamed: D27.2 (A), SW27.2
unnamed: D28.2 (A), SW28.2
unnamed: D29.2 (A), SW29.2
unnamed: D30.2 (A), SW30.2
unnamed: D31.2 (A), SW31.2
unnamed: D32.2 (A), SW32.2
unnamed: D33.2 (A), SW33.2
unnamed: D34.2 (A), SW34.2
unnamed: D35.2 (A), SW35.2
unnamed: D36.2 (A), SW36.2
unnamed: D37.2 (A), SW37.2
unnamed: D38.2 (A), SW38.2
unnamed: D39.2 (A), SW39.2
unnamed: D40.2 (A), SWE20.4
unnamed: D41.2 (A), SWE22.4
unnamed: D44.2 (A), SW44.2
unnamed: D46.2 (A), SW46.2
unnamed: D48.2 (A), SW48.2
unnamed: D54.2 (A), SW54.2
unnamed: D56.2 (A), SW56.2
unnamed: D58.2 (A), SW58.2
unnamed: D64.2 (A), SW64.2
unnamed: D66.2 (A), SW66.2
unnamed: D68.2 (A), SW68.2
unnamed: D110.2 (A), SW110.2
unnamed: D111.2 (A), SW111.2
unnamed: D112.2 (A), SWE14.4
unnamed: D113.2 (A), SWE08.3 (S2)
unnamed: D114.2 (A), SWE012.3 (S2)
unnamed: D115.2 (A), SWE16.4
unnamed: D210.2 (A), SW210.2
unnamed: D211.2 (A), SW211.2
unnamed: D212.2 (A), SWE18.3 (S2)
unnamed: D310.2 (A), SWE24.4
unnamed: D311.2 (A), SWE26.4
unnamed: D312.2 (A), SWE28.4
unnamed: D313.2 (A), SWE210.4
unnamed: D314.2 (A), SWE212.4
unnamed: D315.2 (A), SWE214.4
unnamed: D410.2 (A), SW410.2
unnamed: D412.2 (A), SW412.2
unnamed: D414.2 (A), SW414.2
unnamed: D510.2 (A), SW510.2
unnamed: D512.2 (A), SW512.2
unnamed: D514.2 (A), SW514.2
unnamed: D610.2 (A), SW610.2
unnamed: D612.2 (A), SW612.2
unnamed: D614.2 (A), SW614.2
ROW0: D00.1 (K), D01.1 (K), D02.1 (K), D03.1 (K), D04.1 (K), D05.1 (K), D06.1 (K), D07.1 (K), D08.1 (K), D09.1 (K); also elsewhere on the board
ROW1: D10.1 (K), D11.1 (K), D12.1 (K), D13.1 (K), D14.1 (K), D15.1 (K), D16.1 (K), D17.1 (K), D18.1 (K), D19.1 (K), D110.1 (K), D111.1 (K), D112.1 (K), D113.1 (K), D114.1 (K), D115.1 (K); also elsewhere on the board
ROW2: D20.1 (K), D21.1 (K), D22.1 (K), D23.1 (K), D24.1 (K), D25.1 (K), D26.1 (K), D27.1 (K), D28.1 (K), D29.1 (K), D210.1 (K), D211.1 (K), D212.1 (K); also elsewhere on the board
ROW3: D30.1 (K), D31.1 (K), D32.1 (K), D33.1 (K), D34.1 (K), D35.1 (K), D36.1 (K), D37.1 (K), D38.1 (K), D39.1 (K), D310.1 (K), D311.1 (K), D312.1 (K), D313.1 (K), D314.1 (K), D315.1 (K); also elsewhere on the board
ROW4: D40.1 (K), D41.1 (K), D44.1 (K), D46.1 (K), D48.1 (K), D410.1 (K), D412.1 (K), D414.1 (K); also elsewhere on the board
ROW5: D54.1 (K), D56.1 (K), D58.1 (K), D510.1 (K), D512.1 (K), D514.1 (K); also elsewhere on the board
ROW6: D64.1 (K), D66.1 (K), D68.1 (K), D610.1 (K), D612.1 (K), D614.1 (K); also elsewhere on the board

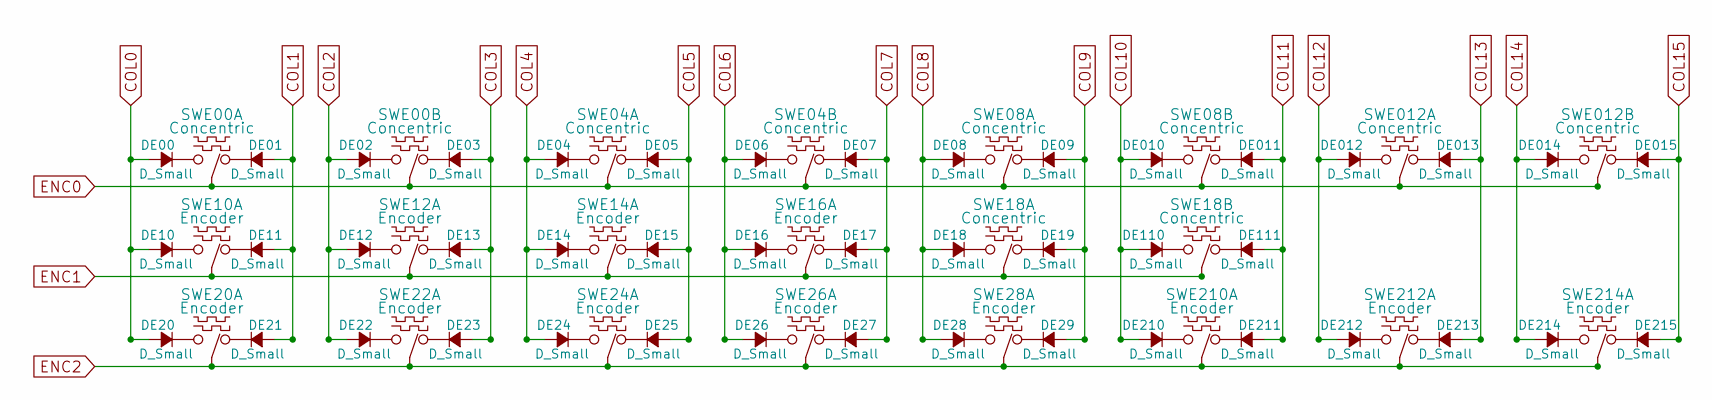
[picture p33: schematic encmatrix.sch, Rotary Encoder Matrix]

Parts:
DE00, DE01, DE02, DE03, DE04, DE05, DE06, DE07, DE08, DE09, DE010, DE10, DE011, DE11, DE012, DE12, DE013, DE13, DE014, DE14, DE015, DE15, DE16, DE17, DE18, DE19, DE20, DE21, DE22, DE23, DE24, DE25, DE26, DE27, DE28, DE29, DE110, DE111, DE210, DE211, DE212, DE213, DE214, DE215: D_Small; SOD-123
SWE00, SWE04, SWE08, SWE012, SWE18: Concentric; e37
SWE10, SWE12, SWE14, SWE16, SWE20, SWE22, SWE24, SWE26, SWE28, SWE210, SWE212, SWE214: Encoder; pec11r

Connections:
COL0: DE00.2 (A), DE10.2 (A), DE20.2 (A); also elsewhere on the board
COL1: DE01.2 (A), DE11.2 (A), DE21.2 (A); also elsewhere on the board
COL2: DE02.2 (A), DE12.2 (A), DE22.2 (A); also elsewhere on the board
COL3: DE03.2 (A), DE13.2 (A), DE23.2 (A); also elsewhere on the board
COL4: DE04.2 (A), DE14.2 (A), DE24.2 (A); also elsewhere on the board
COL5: DE05.2 (A), DE15.2 (A), DE25.2 (A); also elsewhere on the board
COL6: DE06.2 (A), DE16.2 (A), DE26.2 (A); also elsewhere on the board
COL7: DE07.2 (A), DE17.2 (A), DE27.2 (A); also elsewhere on the board
COL8: DE08.2 (A), DE18.2 (A), DE28.2 (A); also elsewhere on the board
COL9: DE09.2 (A), DE19.2 (A), DE29.2 (A); also elsewhere on the board
COL10: DE010.2 (A), DE110.2 (A), DE210.2 (A); also elsewhere on the board
COL11: DE011.2 (A), DE111.2 (A), DE211.2 (A); also elsewhere on the board
COL12: DE012.2 (A), DE212.2 (A); also elsewhere on the board
COL13: DE013.2 (A), DE213.2 (A); also elsewhere on the board
COL14: DE014.2 (A), DE214.2 (A); also elsewhere on the board
COL15: DE015.2 (A), DE215.2 (A); also elsewhere on the board
ENC0: SWE00.4 (Ci), SWE00.9 (Co), SWE04.4 (Ci), SWE04.9 (Co), SWE08.4 (Ci), SWE08.9 (Co), SWE012.4 (Ci), SWE012.9 (Co); also elsewhere on the board
ENC1: SWE10.2, SWE12.2, SWE14.2, SWE16.2, SWE18.4 (Ci), SWE18.9 (Co); also elsewhere on the board
ENC2: SWE20.2, SWE22.2, SWE24.2, SWE26.2, SWE28.2, SWE210.2, SWE212.2, SWE214.2; also elsewhere on the board
unnamed: DE00.1 (K), SWE00.6 (Bo)
unnamed: DE01.1 (K), SWE00.10 (Ao)
unnamed: DE02.1 (K), SWE00.1 (Bi)
unnamed: DE03.1 (K), SWE00.5 (Ai)
unnamed: DE04.1 (K), SWE04.6 (Bo)
unnamed: DE05.1 (K), SWE04.10 (Ao)
unnamed: DE06.1 (K), SWE04.1 (Bi)
unnamed: DE07.1 (K), SWE04.5 (Ai)
unnamed: DE08.1 (K), SWE08.6 (Bo)
unnamed: DE09.1 (K), SWE08.10 (Ao)
unnamed: DE010.1 (K), SWE08.1 (Bi)
unnamed: DE10.1 (K), SWE10.3
unnamed: DE011.1 (K), SWE08.5 (Ai)
unnamed: DE11.1 (K), SWE10.1
unnamed: DE012.1 (K), SWE012.6 (Bo)
unnamed: DE12.1 (K), SWE12.3
unnamed: DE013.1 (K), SWE012.10 (Ao)
unnamed: DE13.1 (K), SWE12.1
unnamed: DE014.1 (K), SWE012.1 (Bi)
unnamed: DE14.1 (K), SWE14.3
unnamed: DE015.1 (K), SWE012.5 (Ai)
unnamed: DE15.1 (K), SWE14.1
unnamed: DE16.1 (K), SWE16.3
unnamed: DE17.1 (K), SWE16.1
unnamed: DE18.1 (K), SWE18.6 (Bo)
unnamed: DE19.1 (K), SWE18.10 (Ao)
unnamed: DE20.1 (K), SWE20.3
unnamed: DE21.1 (K), SWE20.1
unnamed: DE22.1 (K), SWE22.3
unnamed: DE23.1 (K), SWE22.1
unnamed: DE24.1 (K), SWE24.3
unnamed: DE25.1 (K), SWE24.1
unnamed: DE26.1 (K), SWE26.3
unnamed: DE27.1 (K), SWE26.1
unnamed: DE28.1 (K), SWE28.3
unnamed: DE29.1 (K), SWE28.1
unnamed: DE110.1 (K), SWE18.1 (Bi)
unnamed: DE111.1 (K), SWE18.5 (Ai)
unnamed: DE210.1 (K), SWE210.3
unnamed: DE211.1 (K), SWE210.1
unnamed: DE212.1 (K), SWE212.3
unnamed: DE213.1 (K), SWE212.1
unnamed: DE214.1 (K), SWE214.3
unnamed: DE215.1 (K), SWE214.1

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
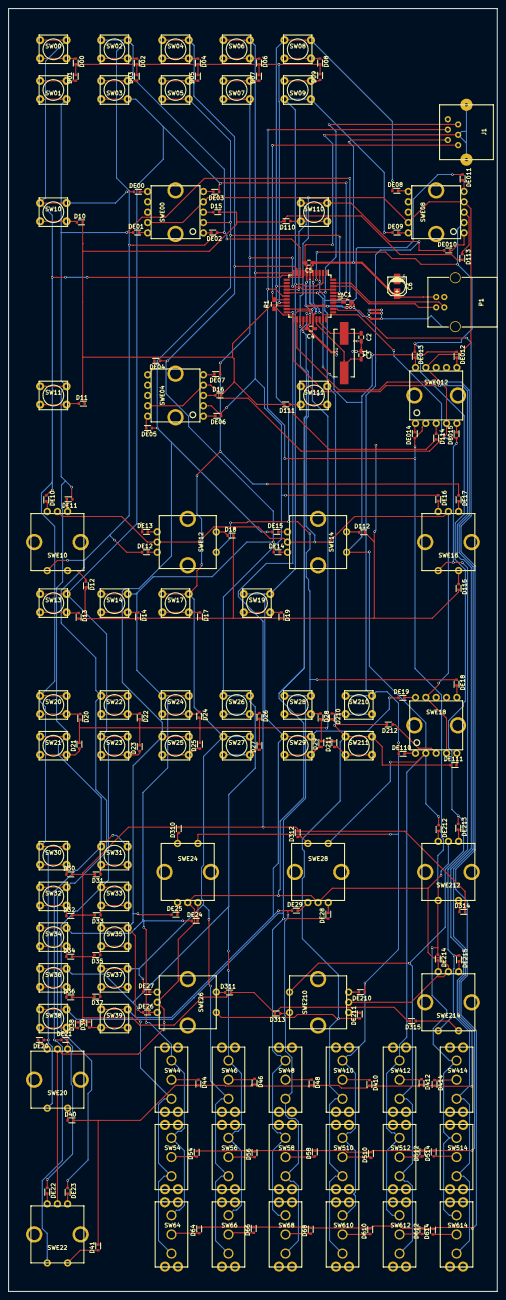
[picture p34: board knobly.kicad_pcb from above]

Board: 2 copper layers, 120.0 x 315.0 mm, 205 parts (0 on the bottom side), 153 nets.
