smurn/knobly/(commit log)

2017-12-11 Adding kicad project for PCB and frontpanel.
    [M2018ES2G13.stl, controller.sch, encmatrix.sch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]
2017-12-11 Added 3d models
    [M2018ES2G13.stl, M2018ES2G13_binary.stl, cap.scad, cap.stl, case.scad, centermount.stl, clamp_plate.scad, clamp_plate.stl]
2018-01-06 Fix bug that caused knobly to freeze after a few minutes.
    [kbly_hid.c, kbly_hid.h, main.c]
2018-04-22 older stuff
    [12039.stp, CH13-E37-Dummy-E37-VTXXX0-1-C.stp, M2018ES2G13.stl, M2018ES2G13.stp, M2018ES2G13_binary.stl, bottommount.stl, cap.scad, cap.stl]
